thunderclap-io/enclustra-pe1-clockinjector/docs/bottom.png

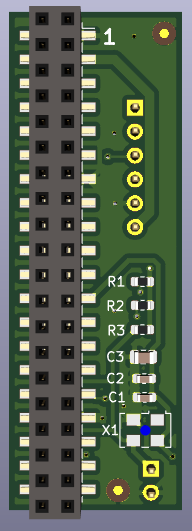
docs/bottom.png
