thunderclap-io/enclustra-pe1-clockinjector/docs/top.png

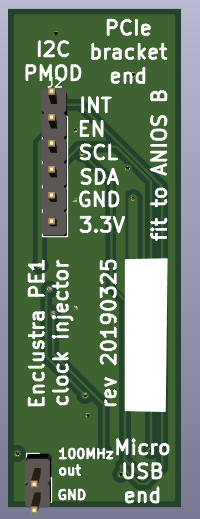
docs/top.png
