thunderclap-io/enclustra-pe1-clockinjector/(commit log)

2019-03-18 Draw schematic of clock injector for Enclustra PE1
    [enclustra_clockpcb.kicad_pcb, enclustra_clockpcb.sch]
2019-03-18 Swap 40 way from header to socket, aligned correctly
    [enclustra_clockpcb.kicad_pcb, enclustra_clockpcb.sch]
2019-03-26 Redo layout, add lots of silkscreen labels. Add pours and board outline
    [enclustra_clockpcb.kicad_pcb, enclustra_clockpcb.sch]
2019-03-26 Gerbers for first prototype, shipped for manufacturing
    [enclustra_clockpcb-B.Cu.gbl, enclustra_clockpcb-B.Mask.gbs, enclustra_clockpcb-B.Paste.gbp, enclustra_clockpcb-B.SilkS.gbo, enclustra_clockpcb-Edge.Cuts.gm1, enclustra_clockpcb-F.Cu.gtl, enclustra_clockpcb-F.Mask.gts, enclustra_clockpcb-F.Paste.gtp]
2019-03-26 Crop board images
